dertrennawieser/stm32_resonance_driver/schematic/stm32_resonance_driver.pdf

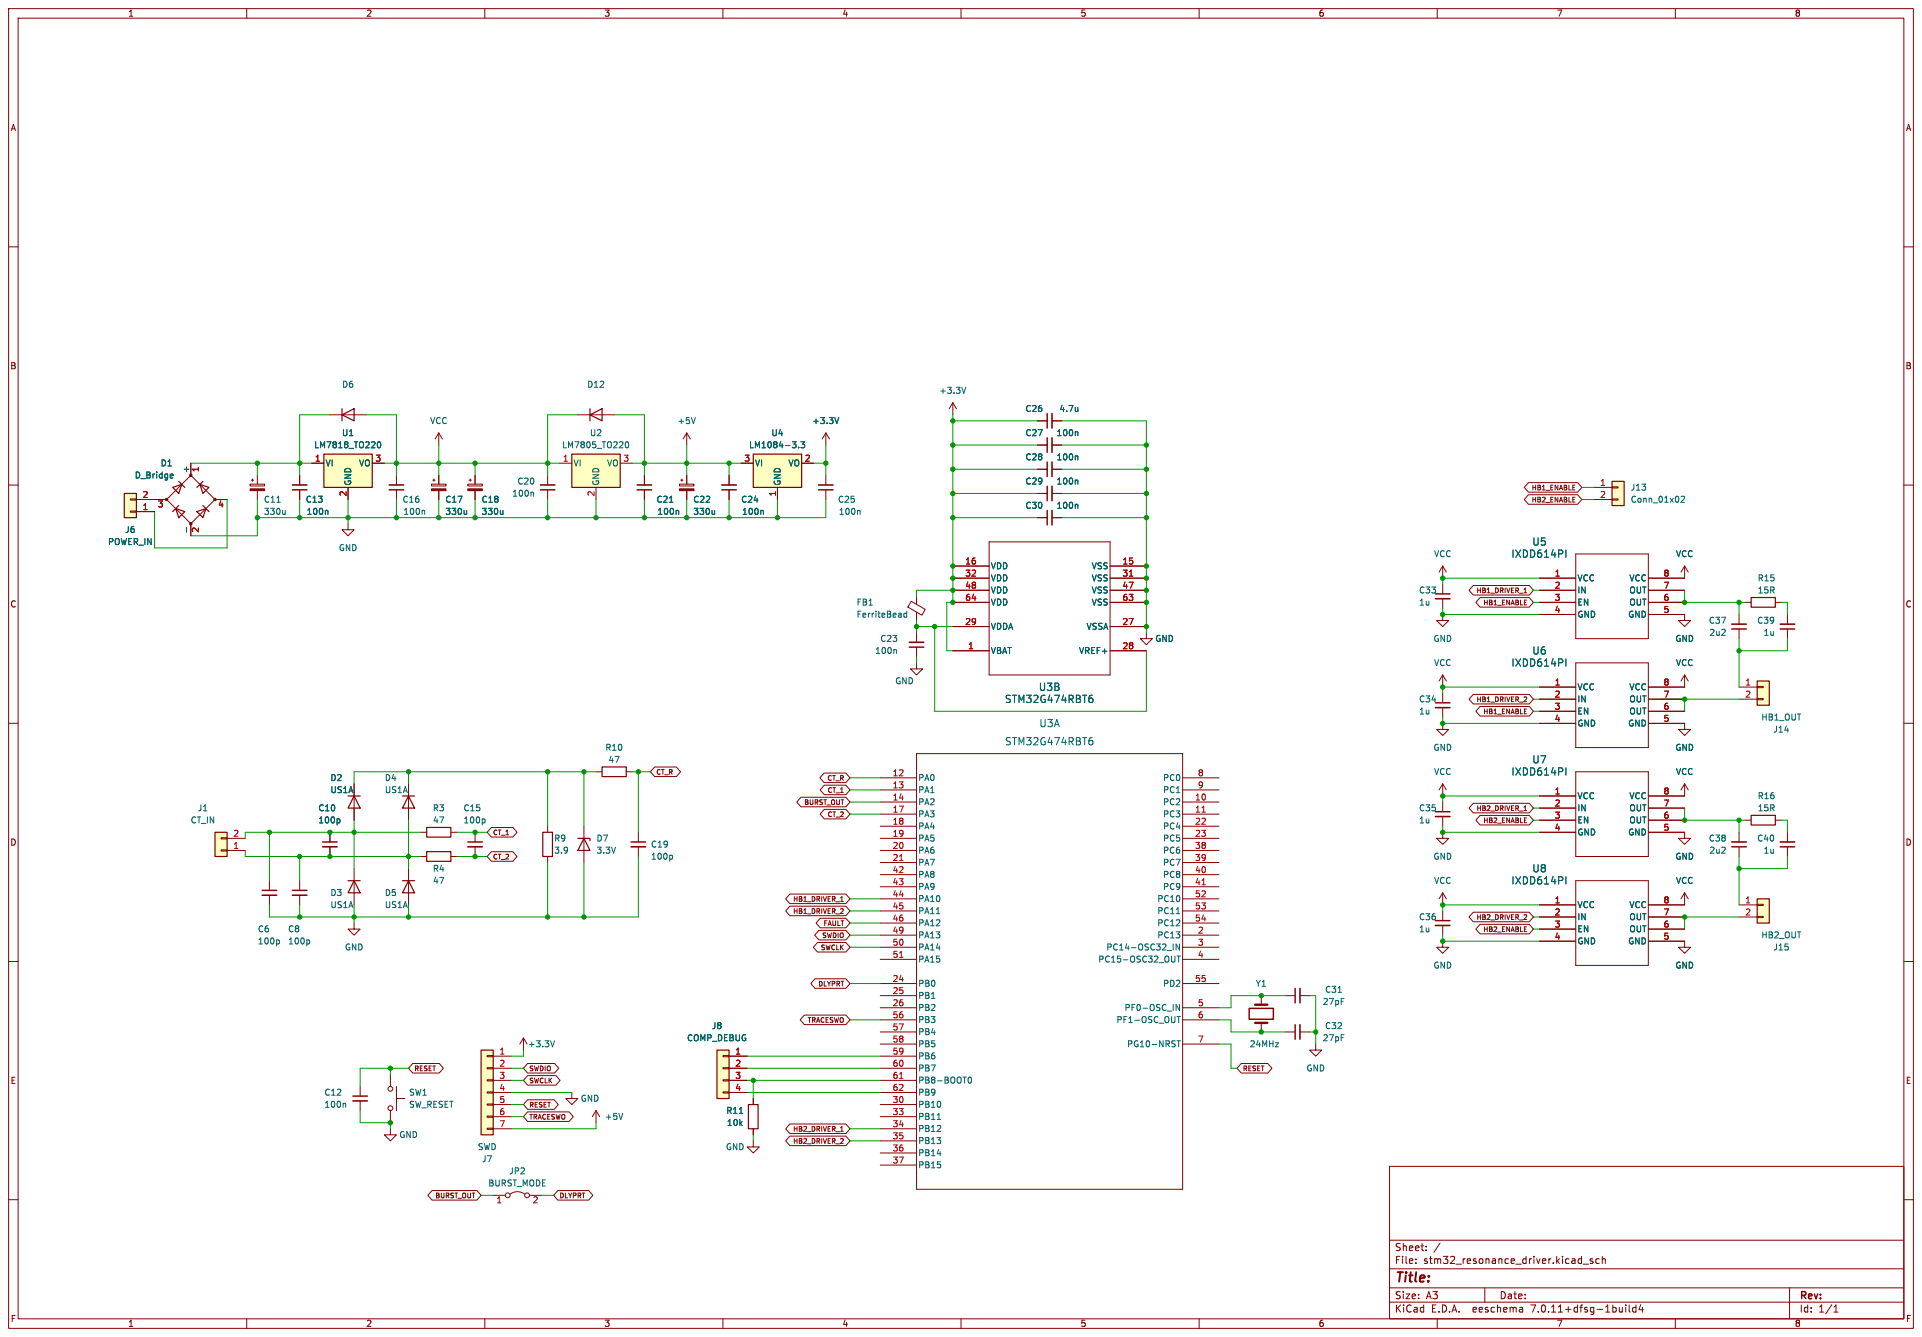
[picture p1: page 1]

Id: 1/1 Title: File: stm32_resonance_driver.kicad_sch Sheet: /
