dertrennawieser/stm32_resonance_driver/example/drsstc/schematic/stm32_drsstc.pdf

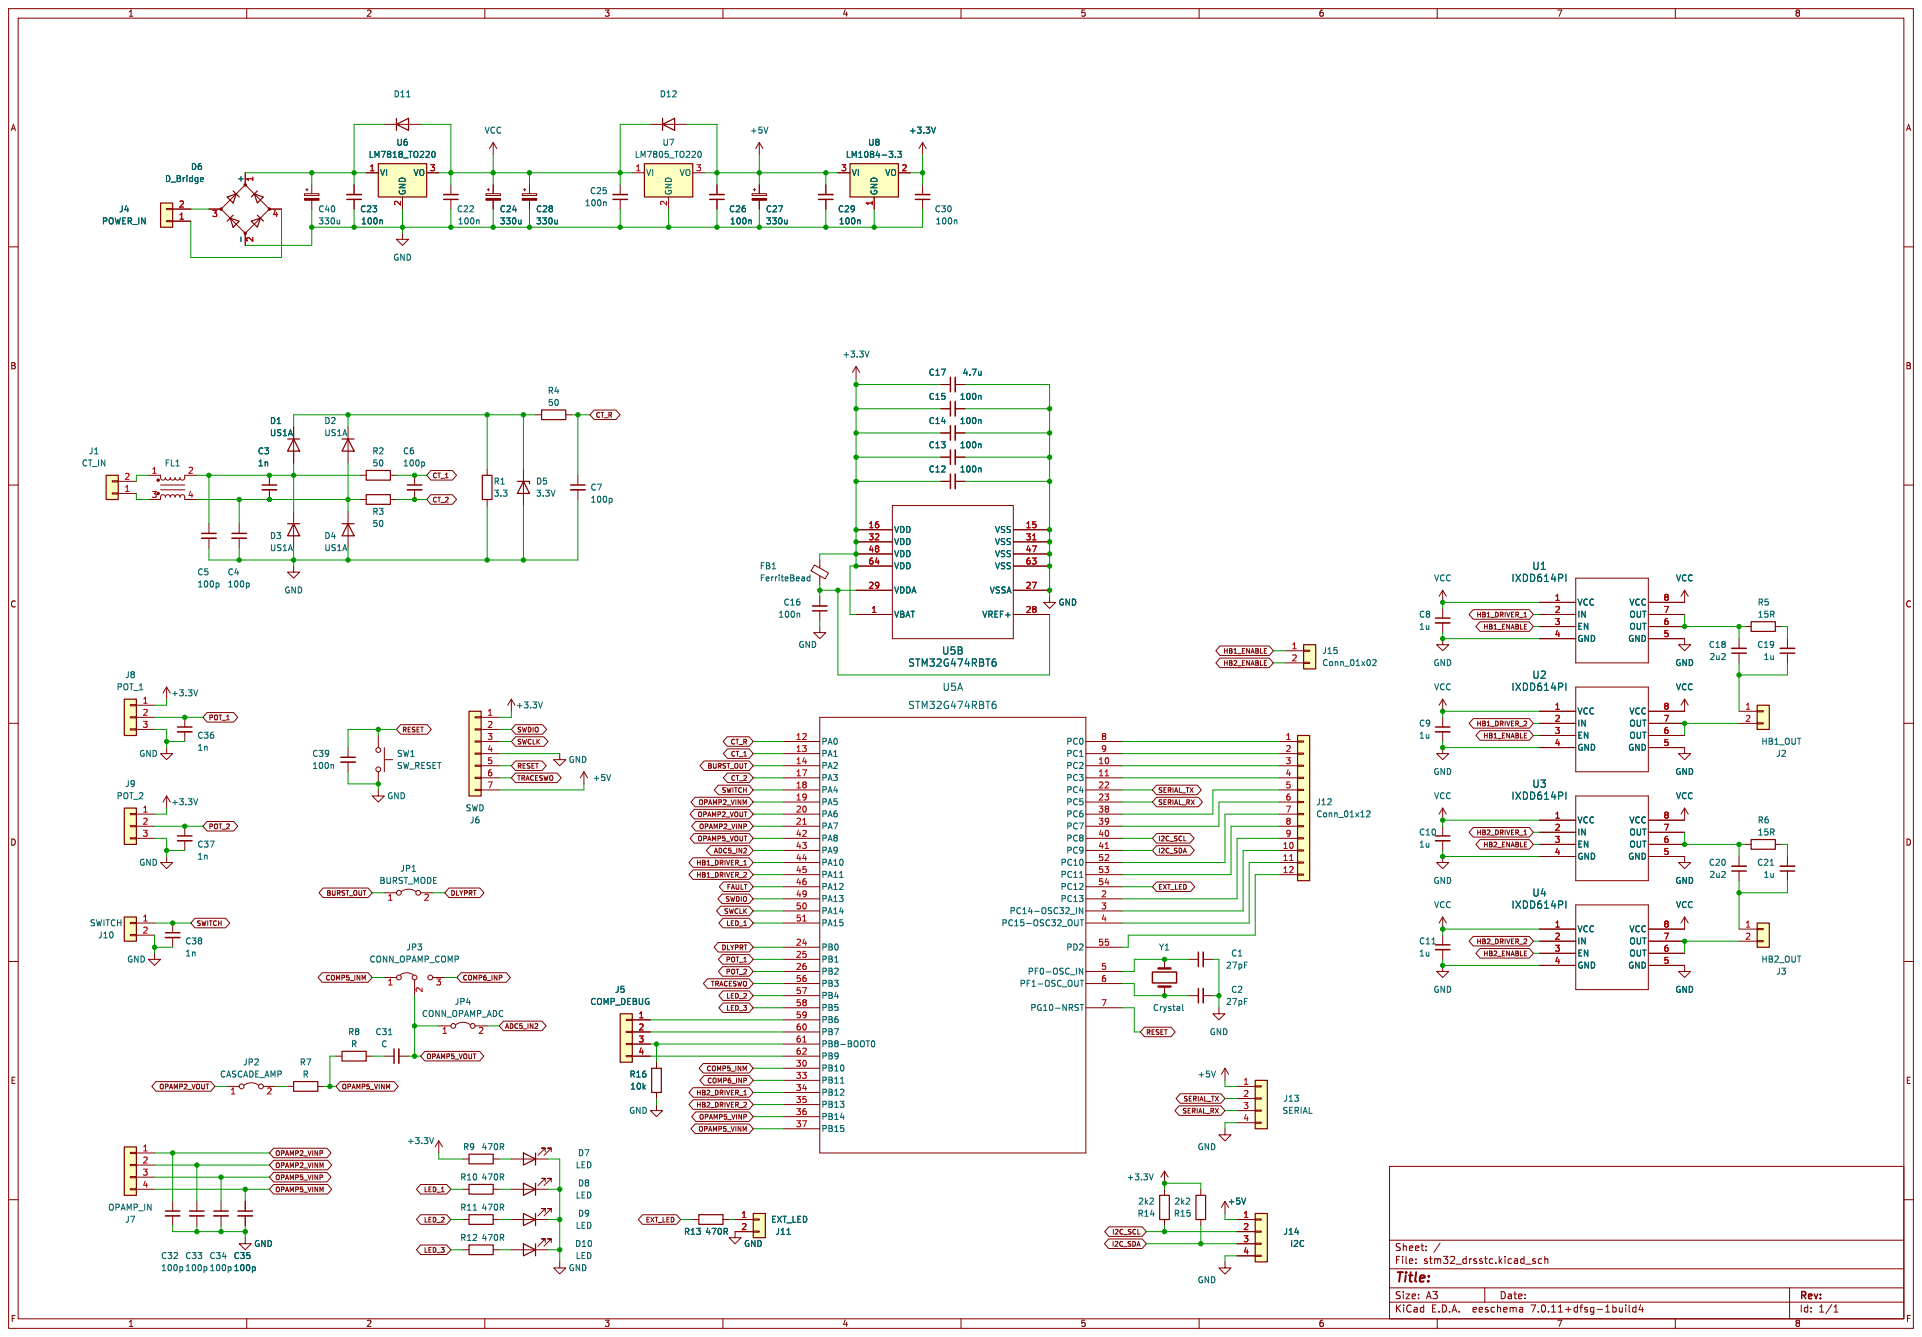
[picture p2: page 1]

Id: 1/1 Title: File: stm32_drsstc.kicad_sch Sheet: / GND
