dertrennawieser/stm32_resonance_driver/schematic/stm32_resonance_driver.kicad_sch

## KiCad design schematic/stm32_resonance_driver.kicad_sch (2025-05-20)

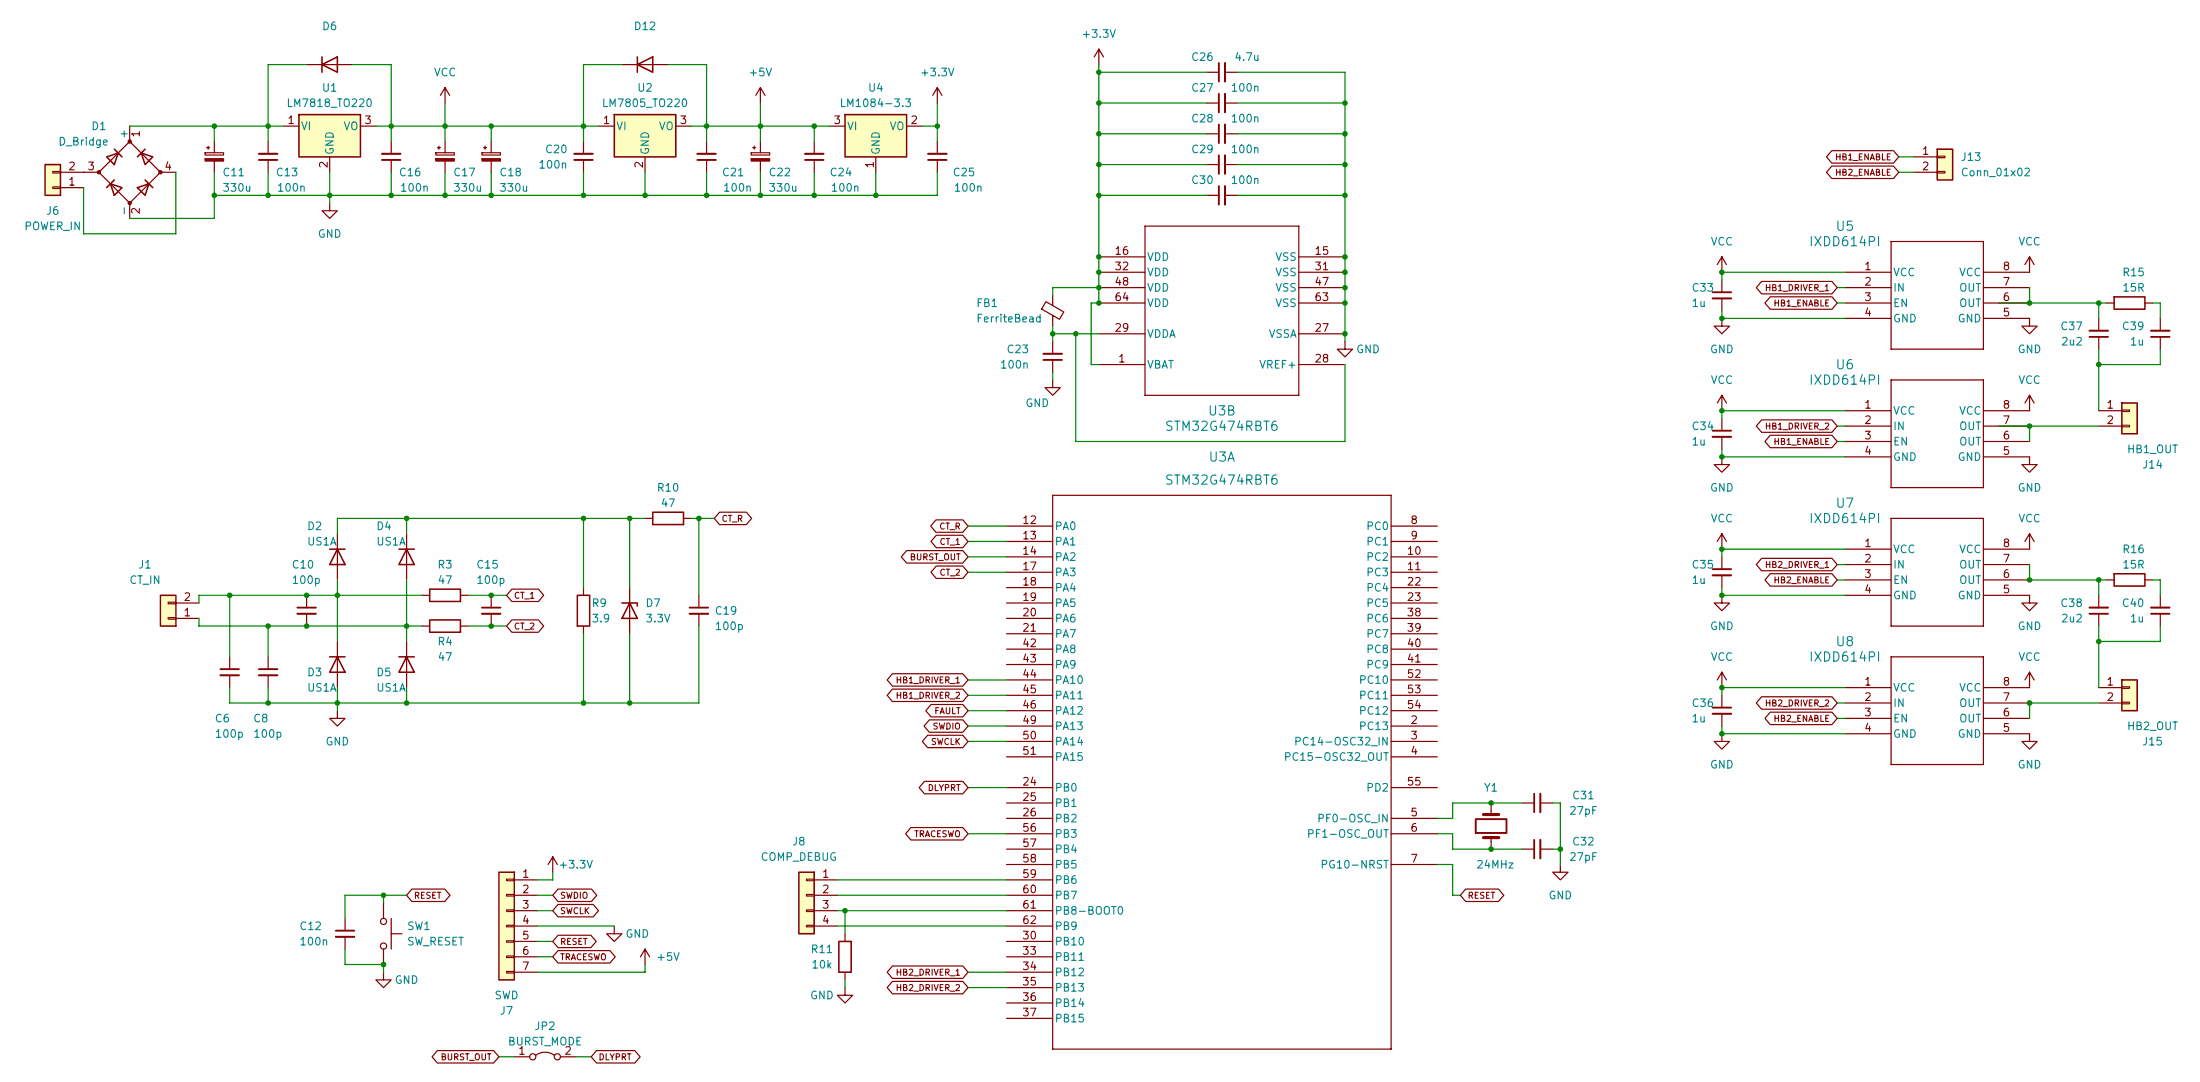
[picture p3: schematic stm32_resonance_driver.kicad_sch]

Parts:
C6, C8, C10, C15, C19: 100p; C_1206_3216Metric_Pad1.33x1.80mm_HandSolder
C11, C17, C18, C22: 330u; CP_Radial_D10.0mm_P5.00mm
C12, C13, C16, C20, C21, C23, C24, C25, C27, C28, C29, C30: 100n; C_1206_3216Metric_Pad1.33x1.80mm_HandSolder
C26: 4.7u; C_1206_3216Metric_Pad1.33x1.80mm_HandSolder
C31, C32: 27pF; C_1206_3216Metric_Pad1.33x1.80mm_HandSolder
C33, C34, C35, C36, C39, C40: 1u; C_1206_3216Metric_Pad1.33x1.80mm_HandSolder
C37, C38: 2u2; C_1206_3216Metric_Pad1.33x1.80mm_HandSolder
D1: D_Bridge; Diode_Bridge_OnSemi_SDIP-4L
D2, D3, D4, D5: US1A; D_SMA_Handsoldering
D6, D12: D; D_SMA_Handsoldering
D7: 3.3V; D_SMA_Handsoldering
FB1: FerriteBead; R_1206_3216Metric_Pad1.30x1.75mm_HandSolder
J1: CT_IN; TerminalBlock_bornier-2_P5.08mm
J6: POWER_IN; TerminalBlock_bornier-2_P5.08mm
J7: SWD; PinHeader_1x07_P2.54mm_Vertical
J8: COMP_DEBUG; PinHeader_1x04_P2.54mm_Vertical
J13: Conn_01x02; PinHeader_1x02_P2.54mm_Vertical
J14: HB1_OUT; TerminalBlock_bornier-2_P5.08mm
J15: HB2_OUT; TerminalBlock_bornier-2_P5.08mm
JP2: BURST_MODE; PinHeader_1x02_P2.54mm_Vertical
R3, R4, R10: 47; R_1206_3216Metric_Pad1.30x1.75mm_HandSolder
R9: 3.9; R_Axial_DIN0411_L9.9mm_D3.6mm_P12.70mm_Horizontal
R11: 10k; R_1206_3216Metric_Pad1.30x1.75mm_HandSolder
R15, R16: 15R; R_1206_3216Metric_Pad1.30x1.75mm_HandSolder
SW1: SW_RESET; SW_SPST_B3S-1000
U1: LM7818_TO220; TO-220-3_Vertical
U2: LM7805_TO220; TO-220-3_Vertical
U3: STM32G474RBT6; LQFP-64_10x10mm_P0.5mm
U4: LM1084-3.3; TO-220-3_Vertical
U5, U6, U7, U8: IXDD614PI; DIP-8_W7.62mm_Socket
Y1: 24MHz; Crystal_SMD_HC49-SD_HandSoldering

Connections:
+3.3V: C25.2, C26.1, C27.1, C28.1, C29.1, C30.1, FB1.1, J7.1, U3.1 (VBAT), U3.16 (VDD), U3.32 (VDD), U3.48 (VDD), U3.64 (VDD), U4.2 (VO)
+5V: C21.2, C22.1, C24.2, D12.2 (A), J7.7, U2.3 (VO), U4.3 (VI)
BURST_OUT: JP2.1 (A), U3.14 (PA2)
CT_1: C15.1, R3.2, U3.13 (PA1)
CT_2: C15.2, R4.2, U3.17 (PA3)
CT_R: C19.1, R10.2, U3.12 (PA0)
DLYPRT: JP2.2 (B), U3.24 (PB0)
FAULT: U3.46 (PA12)
GND: C6.2, C8.2, C11.2, C12.2, C13.1, C16.1, C17.2, C18.2, C19.2, C20.1, C21.1, C22.2, C23.1, C24.1, C25.1, C26.2, C27.2, C28.2, C29.2, C30.2, C31.2, C32.2, C33.2, C34.2, C35.2, C36.2, D1.2 (-), D3.2 (A), D5.2 (A), D7.2 (A), J7.4, R9.2, R11.1, SW1.2, U1.2 (GND), U2.2 (GND), U3.15 (VSS), U3.27 (VSSA), U3.31 (VSS), U3.47 (VSS), U3.63 (VSS), U4.1 (GND), U5.4 (GND), U5.5 (GND), U6.4 (GND), U6.5 (GND), U7.4 (GND), U7.5 (GND), U8.4 (GND), U8.5 (GND)
HB1_DRIVER_1: U3.44 (PA10), U5.2 (IN)
HB1_DRIVER_2: U3.45 (PA11), U6.2 (IN)
HB1_ENABLE: J13.1, U5.3 (EN), U6.3 (EN)
HB2_DRIVER_1: U3.34 (PB12), U7.2 (IN)
HB2_DRIVER_2: U3.35 (PB13), U8.2 (IN)
HB2_ENABLE: J13.2, U7.3 (EN), U8.3 (EN)
unnamed: C6.1, C10.1, D2.2 (A), D3.1 (K), J1.2, R3.1
unnamed: C8.1, C10.2, D4.2 (A), D5.1 (K), J1.1, R4.1
unnamed: C11.1, C13.2, D1.1 (+), D6.1 (K), U1.1 (VI)
unnamed: C23.2, FB1.2, U3.28 (VREF+), U3.29 (VDDA)
unnamed: C31.1, U3.5 (PF0-OSC_IN), Y1.2
unnamed: C32.1, U3.6 (PF1-OSC_OUT), Y1.1
unnamed: C37.1, C39.1, J14.1
unnamed: C37.2, R15.2, U5.6 (OUT), U5.7 (OUT)
unnamed: C38.1, C40.1, J15.1
unnamed: C38.2, R16.2, U7.6 (OUT), U7.7 (OUT)
unnamed: C39.2, R15.1
unnamed: C40.2, R16.1
unnamed: D1.3, J6.2
unnamed: D1.4, J6.1
unnamed: D2.1 (K), D4.1 (K), D7.1 (K), R9.1, R10.1
unnamed: J8.1, U3.59 (PB6)
unnamed: J8.2, U3.60 (PB7)
unnamed: J8.3, R11.2, U3.61 (PB8-BOOT0)
unnamed: J8.4, U3.62 (PB9)
unnamed: J14.2, U6.6 (OUT), U6.7 (OUT)
unnamed: J15.2, U8.6 (OUT), U8.7 (OUT)
RESET: C12.1, J7.5, SW1.1, U3.7 (PG10-NRST)
SWCLK: J7.3, U3.50 (PA14)
SWDIO: J7.2, U3.49 (PA13)
TRACESWO: J7.6, U3.56 (PB3)
VCC: C16.2, C17.1, C18.1, C20.2, C33.1, C34.1, C35.1, C36.1, D6.2 (A), D12.1 (K), U1.3 (VO), U2.1 (VI), U5.1 (VCC), U5.8 (VCC), U6.1 (VCC), U6.8 (VCC), U7.1 (VCC), U7.8 (VCC), U8.1 (VCC), U8.8 (VCC)
