dertrennawieser/stm32_resonance_driver/example/drsstc/schematic/stm32_drsstc.kicad_sch

## KiCad design example/drsstc/schematic/stm32_drsstc.kicad_sch (2025-05-20)

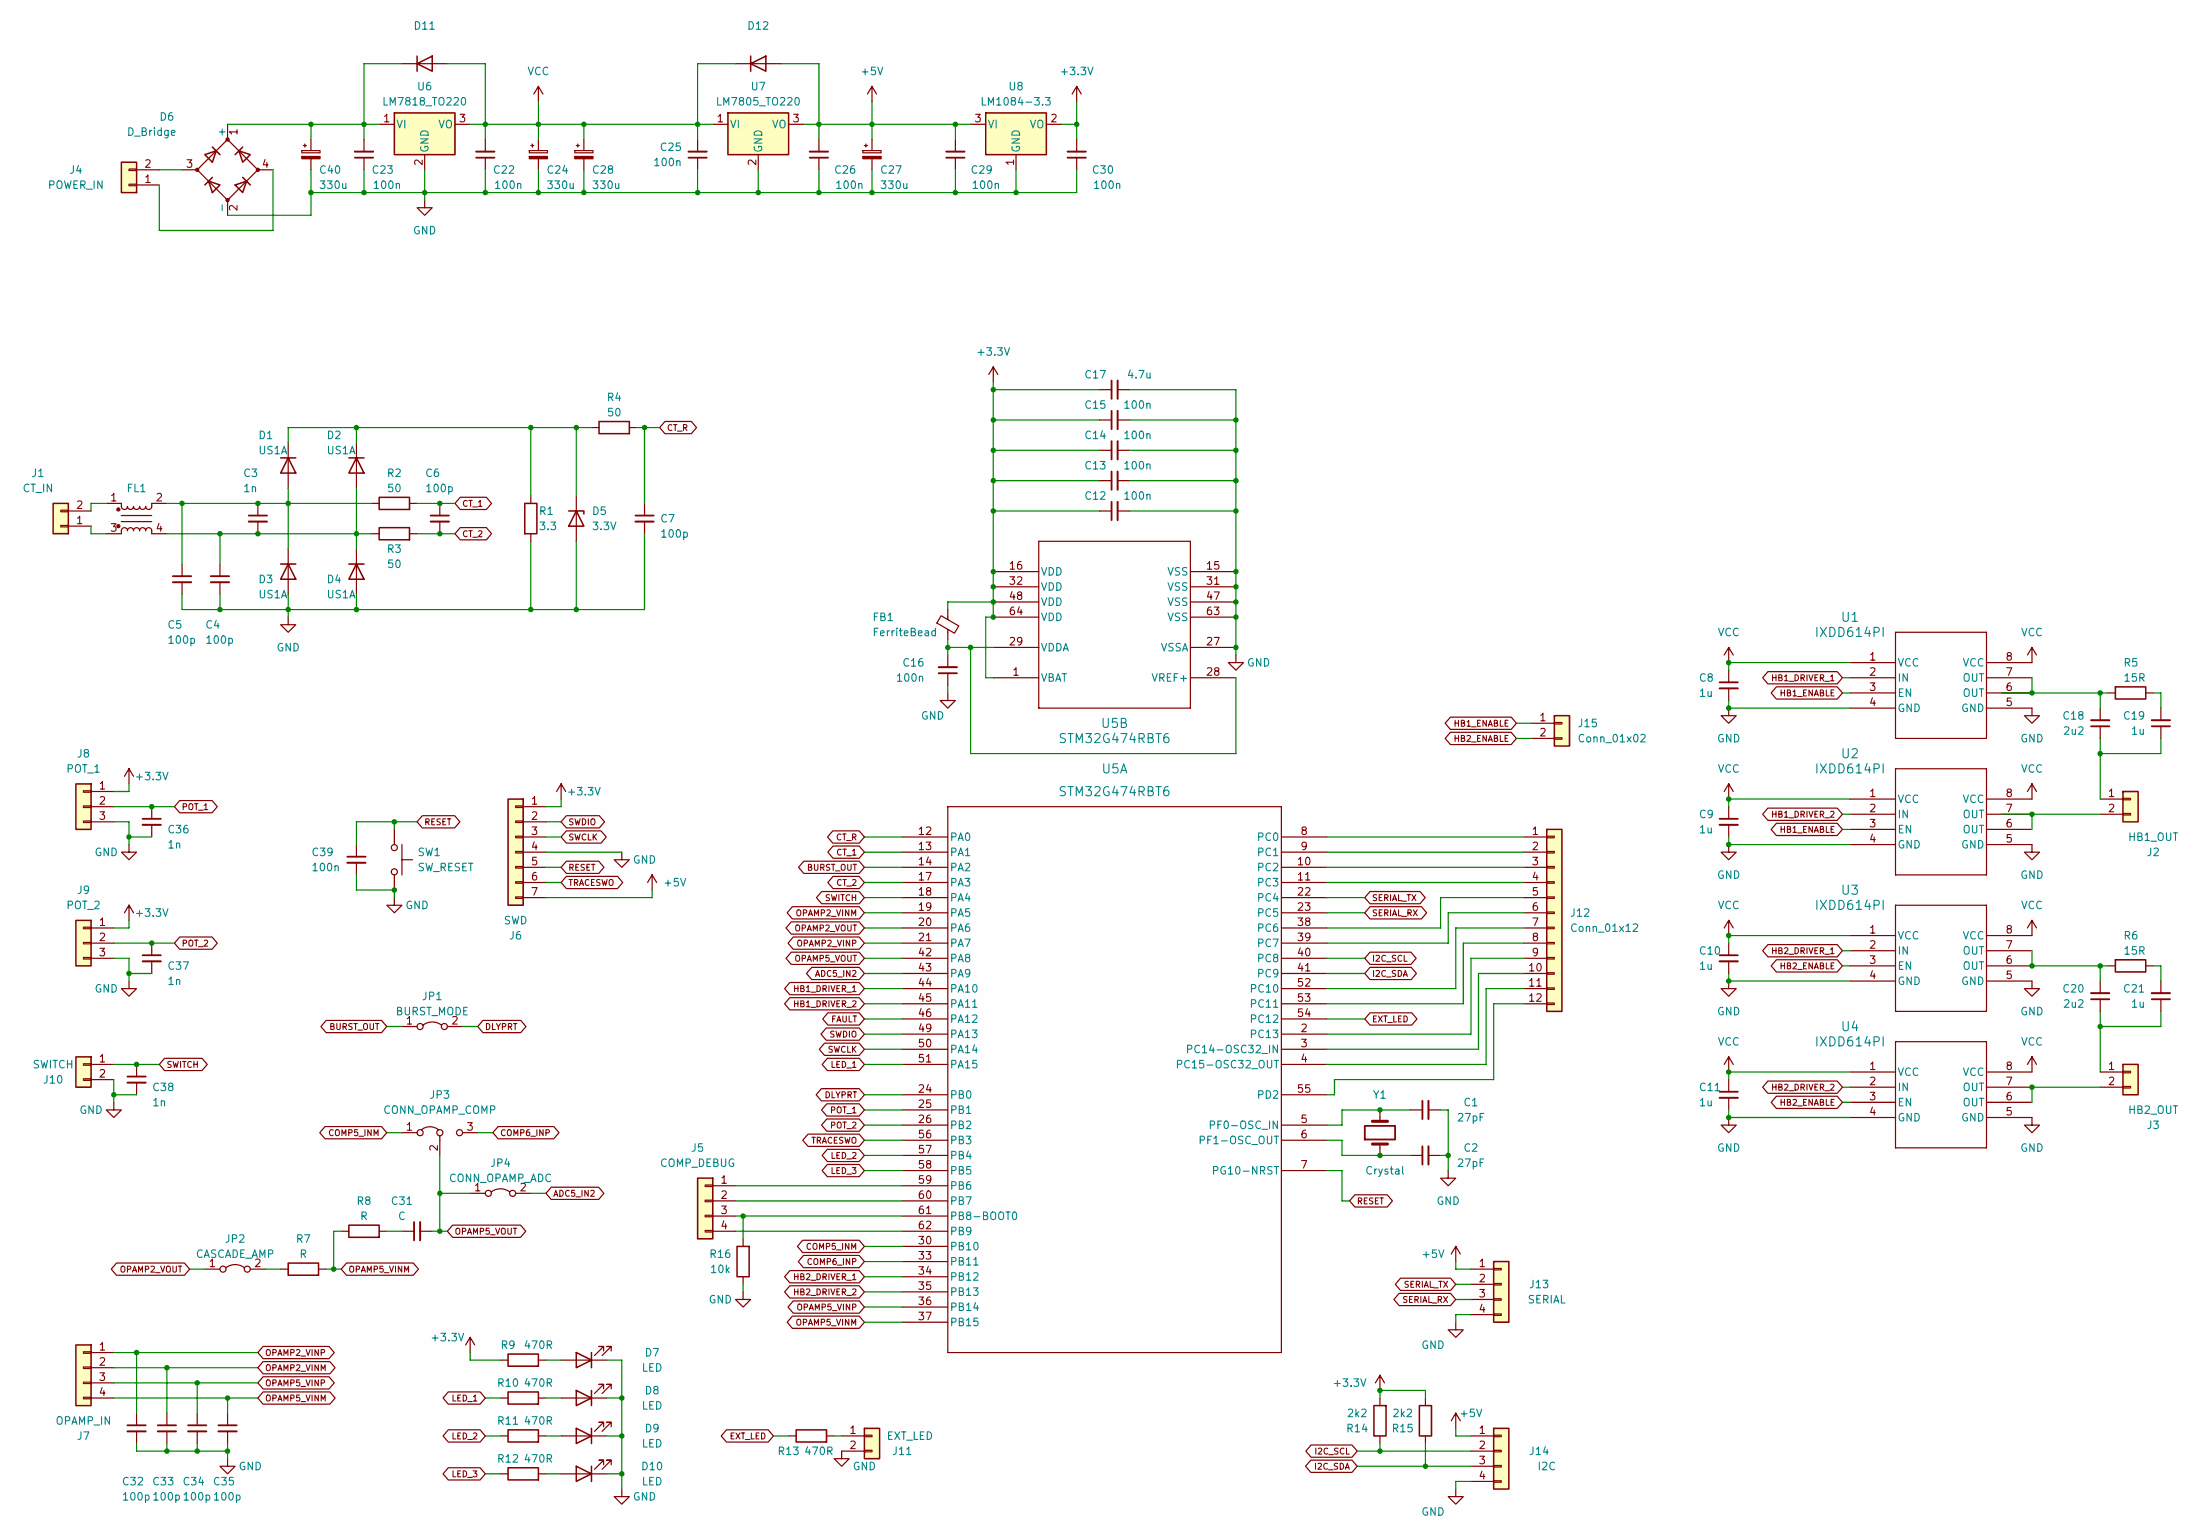
[picture p4: schematic stm32_drsstc.kicad_sch]

Parts:
C1, C2: 27pF; C_1206_3216Metric_Pad1.33x1.80mm_HandSolder
C3, C36, C37, C38: 1n; C_1206_3216Metric_Pad1.33x1.80mm_HandSolder
C4, C5, C6, C7, C32, C33, C34, C35: 100p; C_1206_3216Metric_Pad1.33x1.80mm_HandSolder
C8, C9, C10, C11, C19, C21: 1u; C_1206_3216Metric_Pad1.33x1.80mm_HandSolder
C12, C13, C14, C15, C16, C22, C23, C25, C26, C29, C30, C39: 100n; C_1206_3216Metric_Pad1.33x1.80mm_HandSolder
C17: 4.7u; C_1206_3216Metric_Pad1.33x1.80mm_HandSolder
C18, C20: 2u2; C_1206_3216Metric_Pad1.33x1.80mm_HandSolder
C24, C27, C28, C40: 330u; CP_Radial_D10.0mm_P5.00mm
C31: C; C_Disc_D7.5mm_W2.5mm_P5.00mm
D1, D2, D3, D4: US1A; D_SMA_Handsoldering
D5: 3.3V; D_SMA_Handsoldering
D6: D_Bridge; Diode_Bridge_OnSemi_SDIP-4L
D7, D8, D9, D10: LED; LED_1206_3216Metric_Pad1.42x1.75mm_HandSolder
D11, D12: D; D_SMA_Handsoldering
FB1: FerriteBead; R_1206_3216Metric_Pad1.30x1.75mm_HandSolder
FL1: L_CommonModeChoke_TDK_ACM7060
J1: CT_IN; TerminalBlock_bornier-2_P5.08mm
J2: HB1_OUT; TerminalBlock_bornier-2_P5.08mm
J3: HB2_OUT; TerminalBlock_bornier-2_P5.08mm
J4: POWER_IN; TerminalBlock_bornier-2_P5.08mm
J5: COMP_DEBUG; PinHeader_1x04_P2.54mm_Vertical
J6: SWD; PinHeader_1x07_P2.54mm_Vertical
J7: OPAMP_IN; PinHeader_1x04_P2.54mm_Vertical
J8: POT_1; PinHeader_1x03_P2.54mm_Vertical
J9: POT_2; PinHeader_1x03_P2.54mm_Vertical
J10: SWITCH; PinHeader_1x02_P2.54mm_Vertical
J11: EXT_LED; PinHeader_1x02_P2.54mm_Vertical
J12: Conn_01x12; PinHeader_1x12_P2.54mm_Vertical
J13: SERIAL; PinHeader_1x04_P2.54mm_Vertical
J14: I2C; PinHeader_1x04_P2.54mm_Vertical
J15: Conn_01x02; PinHeader_1x02_P2.54mm_Vertical
JP1: BURST_MODE; PinHeader_1x02_P2.54mm_Vertical
JP2: CASCADE_AMP; PinHeader_1x02_P2.54mm_Vertical
JP3: CONN_OPAMP_COMP; PinHeader_1x03_P2.54mm_Vertical
JP4: CONN_OPAMP_ADC; PinHeader_1x02_P2.54mm_Vertical
R1: 3.3; R_Axial_DIN0411_L9.9mm_D3.6mm_P12.70mm_Horizontal
R2, R3, R4: 50; R_1206_3216Metric_Pad1.30x1.75mm_HandSolder
R5, R6: 15R; R_1206_3216Metric_Pad1.30x1.75mm_HandSolder
R7, R8: R; R_Axial_DIN0207_L6.3mm_D2.5mm_P10.16mm_Horizontal
R9, R10, R11, R12, R13: 470R; R_1206_3216Metric_Pad1.30x1.75mm_HandSolder
R14, R15: 2k2; R_1206_3216Metric_Pad1.30x1.75mm_HandSolder
R16: 10k; R_1206_3216Metric_Pad1.30x1.75mm_HandSolder
SW1: SW_RESET; SW_SPST_B3S-1000
U1, U2, U3, U4: IXDD614PI; DIP-8_W7.62mm_Socket
U5: STM32G474RBT6; LQFP-64_10x10mm_P0.5mm
U6: LM7818_TO220; TO-220-3_Vertical
U7: LM7805_TO220; TO-220-3_Vertical
U8: LM1084-3.3; TO-220-3_Vertical
Y1: Crystal; Crystal_SMD_HC49-SD_HandSoldering

Connections:
+3.3V: C12.1, C13.1, C14.1, C15.1, C17.1, C30.2, FB1.1, J6.1, J8.1, J9.1, R9.1, R14.2, R15.2, U5.1 (VBAT), U5.16 (VDD), U5.32 (VDD), U5.48 (VDD), U5.64 (VDD), U8.2 (VO)
+5V: C26.2, C27.1, C29.2, D12.2 (A), J6.7, J13.1, J14.1, U7.3 (VO), U8.3 (VI)
ADC5_IN2: JP4.2 (B), U5.43 (PA9)
BURST_OUT: JP1.1 (A), U5.14 (PA2)
COMP5_INM: JP3.1 (A), U5.30 (PB10)
COMP6_INP: JP3.3 (B), U5.33 (PB11)
CT_1: C6.1, R2.2, U5.13 (PA1)
CT_2: C6.2, R3.2, U5.17 (PA3)
CT_R: C7.1, R4.2, U5.12 (PA0)
DLYPRT: JP1.2 (B), U5.24 (PB0)
EXT_LED: R13.1, U5.54 (PC12)
FAULT: U5.46 (PA12)
GND: C1.2, C2.2, C4.2, C5.2, C7.2, C8.2, C9.2, C10.2, C11.2, C12.2, C13.2, C14.2, C15.2, C16.1, C17.2, C22.1, C23.1, C24.2, C25.1, C26.1, C27.2, C28.2, C29.1, C30.1, C32.2, C33.2, C34.2, C35.2, C36.2, C37.2, C38.2, C39.2, C40.2, D3.2 (A), D4.2 (A), D5.2 (A), D6.2 (-), D7.1 (K), D8.1 (K), D9.1 (K), D10.1 (K), J6.4, J8.3, J9.3, J10.2, J11.2, J13.4, J14.4, R1.2, R16.1, SW1.2, U1.4 (GND), U1.5 (GND), U2.4 (GND), U2.5 (GND), U3.4 (GND), U3.5 (GND), U4.4 (GND), U4.5 (GND), U5.15 (VSS), U5.27 (VSSA), U5.31 (VSS), U5.47 (VSS), U5.63 (VSS), U6.2 (GND), U7.2 (GND), U8.1 (GND)
HB1_DRIVER_1: U1.2 (IN), U5.44 (PA10)
HB1_DRIVER_2: U2.2 (IN), U5.45 (PA11)
HB1_ENABLE: J15.1, U1.3 (EN), U2.3 (EN)
HB2_DRIVER_1: U3.2 (IN), U5.34 (PB12)
HB2_DRIVER_2: U4.2 (IN), U5.35 (PB13)
HB2_ENABLE: J15.2, U3.3 (EN), U4.3 (EN)
I2C_SCL: J14.2, R14.1, U5.40 (PC8)
I2C_SDA: J14.3, R15.1, U5.41 (PC9)
LED_1: R10.1, U5.51 (PA15)
LED_2: R11.1, U5.57 (PB4)
LED_3: R12.1, U5.58 (PB5)
unnamed: C1.1, U5.5 (PF0-OSC_IN), Y1.2
unnamed: C2.1, U5.6 (PF1-OSC_OUT), Y1.1
unnamed: C3.1, C5.1, D1.2 (A), D3.1 (K), FL1.2, R2.1
unnamed: C3.2, C4.1, D2.2 (A), D4.1 (K), FL1.4, R3.1
unnamed: C16.2, FB1.2, U5.28 (VREF+), U5.29 (VDDA)
unnamed: C18.1, C19.1, J2.1
unnamed: C18.2, R5.2, U1.6 (OUT), U1.7 (OUT)
unnamed: C19.2, R5.1
unnamed: C20.1, C21.1, J3.1
unnamed: C20.2, R6.2, U3.6 (OUT), U3.7 (OUT)
unnamed: C21.2, R6.1
unnamed: C23.2, C40.1, D6.1 (+), D11.1 (K), U6.1 (VI)
unnamed: C31.1, R8.2
unnamed: D1.1 (K), D2.1 (K), D5.1 (K), R1.1, R4.1
unnamed: D6.3, J4.2
unnamed: D6.4, J4.1
unnamed: D7.2 (A), R9.2
unnamed: D8.2 (A), R10.2
unnamed: D9.2 (A), R11.2
unnamed: D10.2 (A), R12.2
unnamed: FL1.1, J1.2
unnamed: FL1.3, J1.1
unnamed: J2.2, U2.6 (OUT), U2.7 (OUT)
unnamed: J3.2, U4.6 (OUT), U4.7 (OUT)
unnamed: J5.1, U5.59 (PB6)
unnamed: J5.2, U5.60 (PB7)
unnamed: J5.3, R16.2, U5.61 (PB8-BOOT0)
unnamed: J5.4, U5.62 (PB9)
unnamed: J11.1, R13.2
unnamed: J12.1, U5.8 (PC0)
unnamed: J12.2, U5.9 (PC1)
unnamed: J12.3, U5.10 (PC2)
unnamed: J12.4, U5.11 (PC3)
unnamed: J12.5, U5.38 (PC6)
unnamed: J12.6, U5.39 (PC7)
unnamed: J12.7, U5.52 (PC10)
unnamed: J12.8, U5.53 (PC11)
unnamed: J12.9, U5.2 (PC13)
unnamed: J12.10, U5.3 (PC14-OSC32_IN)
unnamed: J12.11, U5.4 (PC15-OSC32_OUT)
unnamed: J12.12, U5.55 (PD2)
unnamed: JP2.2 (B), R7.1
OPAMP2_VINM: C33.1, J7.2, U5.19 (PA5)
OPAMP2_VINP: C32.1, J7.1, U5.21 (PA7)
OPAMP2_VOUT: JP2.1 (A), U5.20 (PA6)
OPAMP5_VINM: C35.1, J7.4, R7.2, R8.1, U5.37 (PB15)
OPAMP5_VINP: C34.1, J7.3, U5.36 (PB14)
OPAMP5_VOUT: C31.2, JP3.2 (C), JP4.1 (A), U5.42 (PA8)
POT_1: C36.1, J8.2, U5.25 (PB1)
POT_2: C37.1, J9.2, U5.26 (PB2)
RESET: C39.1, J6.5, SW1.1, U5.7 (PG10-NRST)
SERIAL_RX: J13.3, U5.23 (PC5)
SERIAL_TX: J13.2, U5.22 (PC4)
SWCLK: J6.3, U5.50 (PA14)
SWDIO: J6.2, U5.49 (PA13)
SWITCH: C38.1, J10.1, U5.18 (PA4)
TRACESWO: J6.6, U5.56 (PB3)
VCC: C8.1, C9.1, C10.1, C11.1, C22.2, C24.1, C25.2, C28.1, D11.2 (A), D12.1 (K), U1.1 (VCC), U1.8 (VCC), U2.1 (VCC), U2.8 (VCC), U3.1 (VCC), U3.8 (VCC), U4.1 (VCC), U4.8 (VCC), U6.3 (VO), U7.1 (VI)
